MakeMagazinDE/WOODMILL/(list of files, cad)

Other CAD files:
CAD_DSM/WOODMILL.skp
cad/WOODMILL.skp
