MakeMagazinDE/WOODMILL/(commit log)

2014-02-19 new sketchup file
    [WOODMILL.skp]
2014-02-19 preview added
    [WOODMILL.skp]
2014-02-19 new CAD plans
    [WOODMILL.skp]
2014-02-19 added Sketchup files
    [WOODMILL.skp]
2014-02-19 screws added
2014-12-07 zipped DesignSparc Mechanical
    [WOODMILL.skp]
2016-04-18 compiled HEX for Arduino
2016-04-18 added info for GRBL
2016-04-18 GRBL 0.9j for woodmill
